citrineio/STM32F103_Temp_Sense/README.md

# STM32F103_Temp_Sense
STM32F103 based development board featuring a TI TMP102 temperature sensor and pin headers for various interfaces.
