citrineio/STM32F103_Temp_Sense/Schematics/Readme.md

# Schematics

Here you can download the schematics files for this project or view the PDF version.
