citrineio/STM32F103_Temp_Sense/Schematics/01-Schematics.kicad_sch

## KiCad design Schematics/01-Schematics.kicad_sch (2023-05-26)

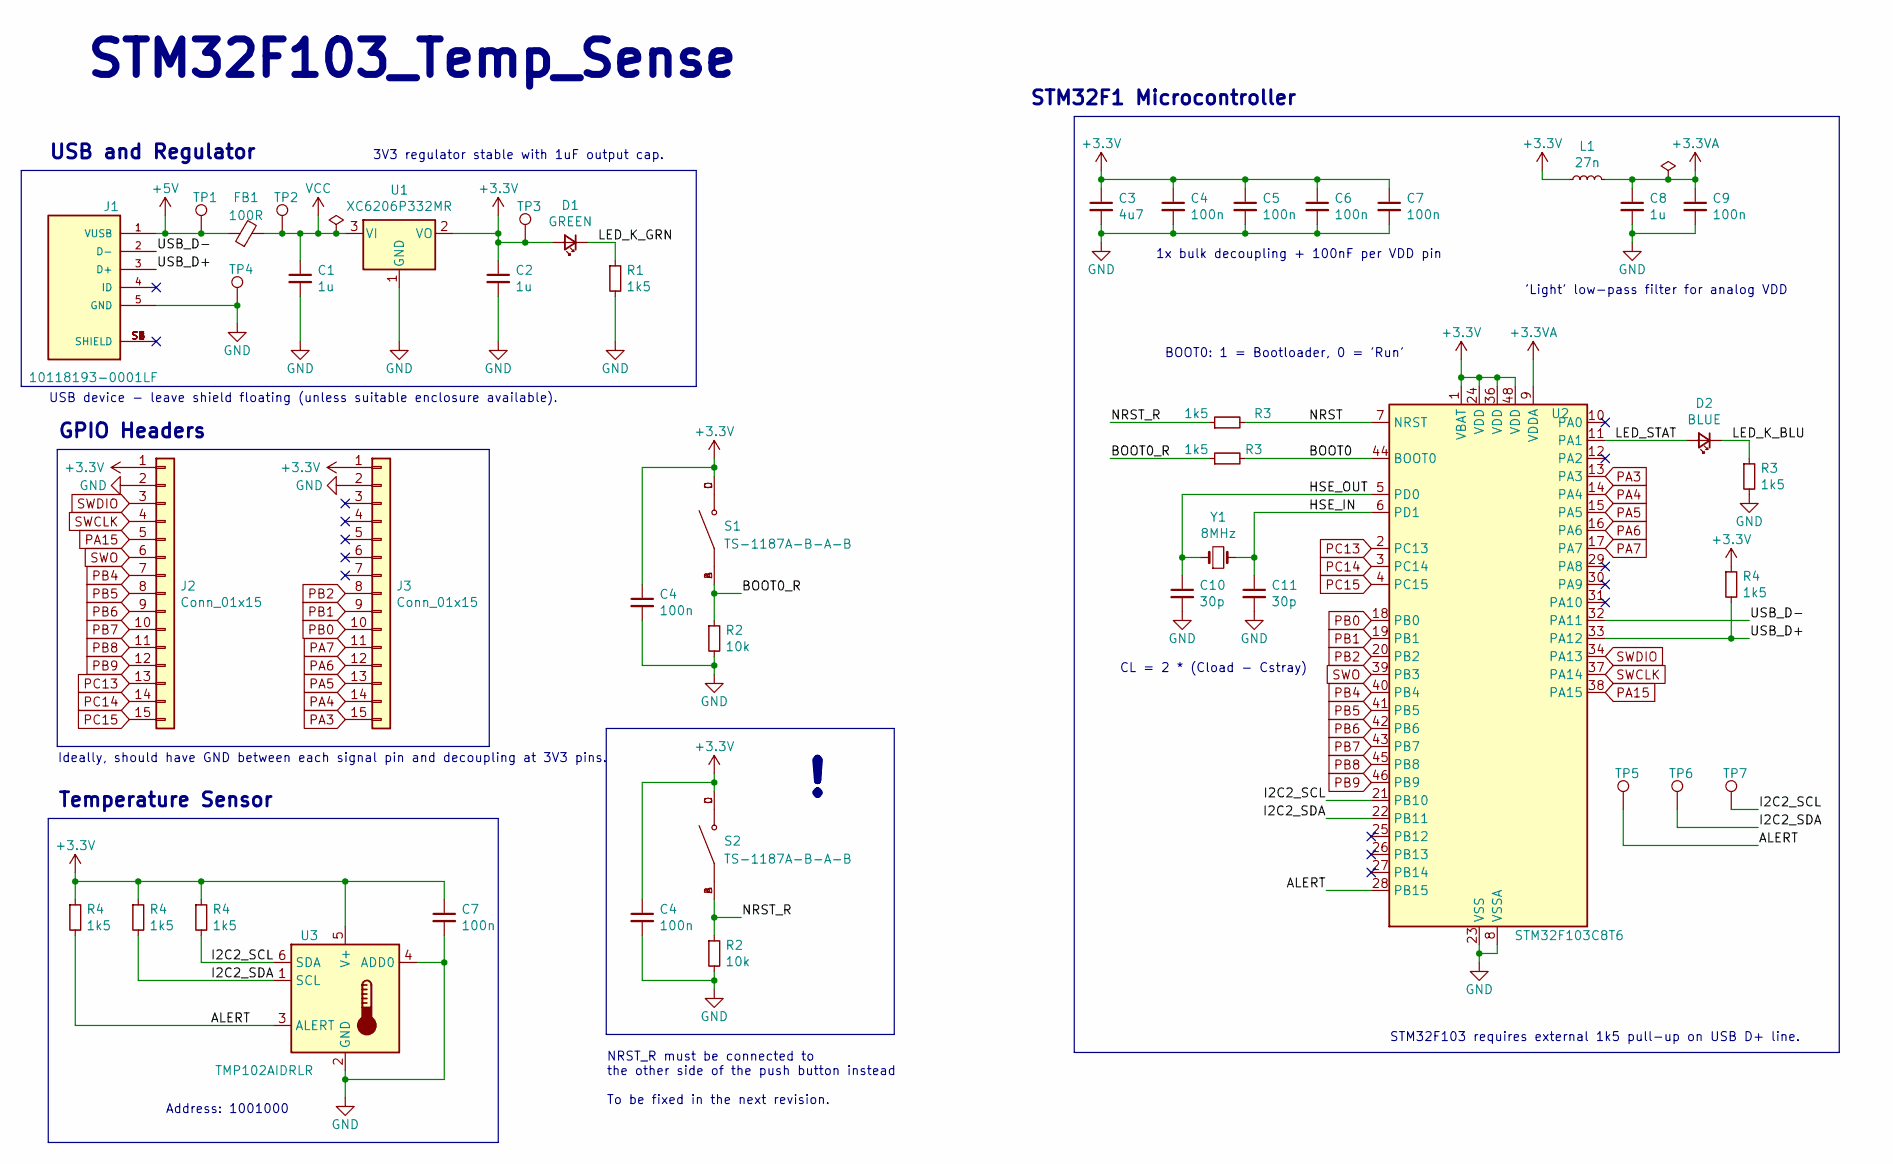
[picture p3: schematic 01-Schematics.kicad_sch]

Parts:
C1, C2: 1u; C_0603_1608Metric; LCSC Part # C15849
C3: 4u7; C_0603_1608Metric; LCSC Part # C19666
C4, C5, C6, C7, C9: 100n; C_0402_1005Metric; LCSC Part # C1525
C8: 1u; C_0402_1005Metric; LCSC Part # C52923
C10, C11: 30p; C_0402_1005Metric; LCSC Part # C1570
D1: GREEN; LED_0603_1608Metric; LCSC Part # C72043
D2: BLUE; LED_0603_1608Metric; LCSC Part # C72041
FB1: 100R; L_0805_2012Metric; LCSC Part # C1015
J1: 10118193-0001LF; AMPHENOL_10118193-0001LF; LCSC Part # C132562
J2, J3: Conn_01x15; PinHeader_1x15_P2.54mm_Vertical; LCSC Part # C2894938
L1: 27n; L_0402_1005Metric; LCSC Part # C18830
R1, R3: 1k5; R_0603_1608Metric; LCSC Part # C22843
R2: 10k; R_0402_1005Metric; LCSC Part # C25744
R4: 1k5; R_0402_1005Metric; LCSC Part # C25867
S1, S2: TS-1187A-B-A-B; SW_TS-1187A-B-A-B; LCSC Part # C318884
TP1, TP2, TP3, TP4, TP5, TP6, TP7: TestPoint; TestPoint_Pad_D1.0mm
U1: XC6206P332MR; SOT-23; LCSC Part # C5446
U2: STM32F103C8T6; LQFP-48_7x7mm_P0.5mm; LCSC Part # C8734
U3: TMP102AIDRLR; SOT50P160X60-6N; LCSC Part # C99269
Y1: 8MHz; Crystal_SMD_5032-2Pin_5.0x3.2mm; LCSC Part # C115962

Connections:
+3.3V: C2.1, C3.1, C4.1, C5.1, C6.1, C7.1, D1.2 (A), J2.1, J3.1, L1.1, R4.1, S1.C, S1.D, S2.C, S2.D, TP3.1, U1.2 (VO), U2.1 (VBAT), U2.24 (VDD), U2.36 (VDD), U2.48 (VDD), U3.5 (V+)
+3.3VA: C8.1, C9.1, L1.2, U2.9 (VDDA)
+5V: FB1.1, J1.1 (VUSB), TP1.1
ALERT: R4.2, TP5.1, U2.28 (PB15), U3.3 (ALERT)
BOOT0: R3.2, U2.44 (BOOT0)
BOOT0_R: R2.1, R3.1, S1.A, S1.B
GND: C1.2, C2.2, C3.2, C4.2, C5.2, C6.2, C7.2, C8.2, C9.2, C10.2, C11.2, J1.5 (GND), J2.2, J3.2, R1.2, R2.2, R3.2, TP4.1, U1.1 (GND), U2.8 (VSSA), U2.23 (VSS), U2.35 (VSS), U2.47 (VSS), U3.2 (GND), U3.4 (ADD0)
HSE_IN: C11.1, U2.6 (PD1), Y1.2
HSE_OUT: C10.1, U2.5 (PD0), Y1.1
I2C2_SCL: R4.2, TP7.1, U2.21 (PB10), U3.6 (SDA)
I2C2_SDA: R4.2, TP6.1, U2.22 (PB11), U3.1 (SCL)
LED_K_BLU: D2.1 (K), R3.1
LED_K_GRN: D1.1 (K), R1.1
LED_STAT: D2.2 (A), U2.11 (PA1)
NRST: R3.2, U2.7 (NRST)
NRST_R: R2.1, R3.1, S2.A, S2.B
unnamed: J1.S1 (SHIELD), J1.S2 (SHIELD), J1.S3 (SHIELD), J1.S4 (SHIELD), J1.S5 (SHIELD), J1.S6 (SHIELD)
PA3: J3.15, U2.13 (PA3)
PA4: J3.14, U2.14 (PA4)
PA5: J3.13, U2.15 (PA5)
PA6: J3.12, U2.16 (PA6)
PA7: J3.11, U2.17 (PA7)
PA15: J2.5, U2.38 (PA15)
PB0: J3.10, U2.18 (PB0)
PB1: J3.9, U2.19 (PB1)
PB2: J3.8, U2.20 (PB2)
PB4: J2.7, U2.40 (PB4)
PB5: J2.8, U2.41 (PB5)
PB6: J2.9, U2.42 (PB6)
PB7: J2.10, U2.43 (PB7)
PB8: J2.11, U2.45 (PB8)
PB9: J2.12, U2.46 (PB9)
PC13: J2.13, U2.2 (PC13)
PC14: J2.14, U2.3 (PC14)
PC15: J2.15, U2.4 (PC15)
SWCLK: J2.4, U2.37 (PA14)
SWDIO: J2.3, U2.34 (PA13)
SWO: J2.6, U2.39 (PB3)
USB_D+: J1.3 (D+), R4.2, U2.33 (PA12)
USB_D-: J1.2 (D-), U2.32 (PA11)
VCC: C1.1, FB1.2, TP2.1, U1.3 (VI)

Notes on the sheet:
3V3 regulator stable with 1uF output cap.
'Light' low-pass filter for analog VDD
USB device - leave shield floating (unless suitable enclosure available).
STM32F1 Microcontroller
STM32F103 requires external 1k5 pull-up on USB D+ line.
GPIO Headers
1x bulk decoupling + 100nF per VDD pin
USB and Regulator
CL = 2 * (Cload - Cstray)
Temperature Sensor
Address: 1001000
STM32F103_Temp_Sense
BOOT0: 1 = Bootloader, 0 = 'Run'
NRST_R must be connected to the other side of the push button instead To be fixed in the next revision.
Ideally, should have GND between each signal pin and decoupling at 3V3 pins.
