citrineio/STM32F103_Temp_Sense/Schematics/STM32F103_Temp_Sense.kicad_sch

## KiCad design Schematics/STM32F103_Temp_Sense.kicad_sch (2023-05-26)

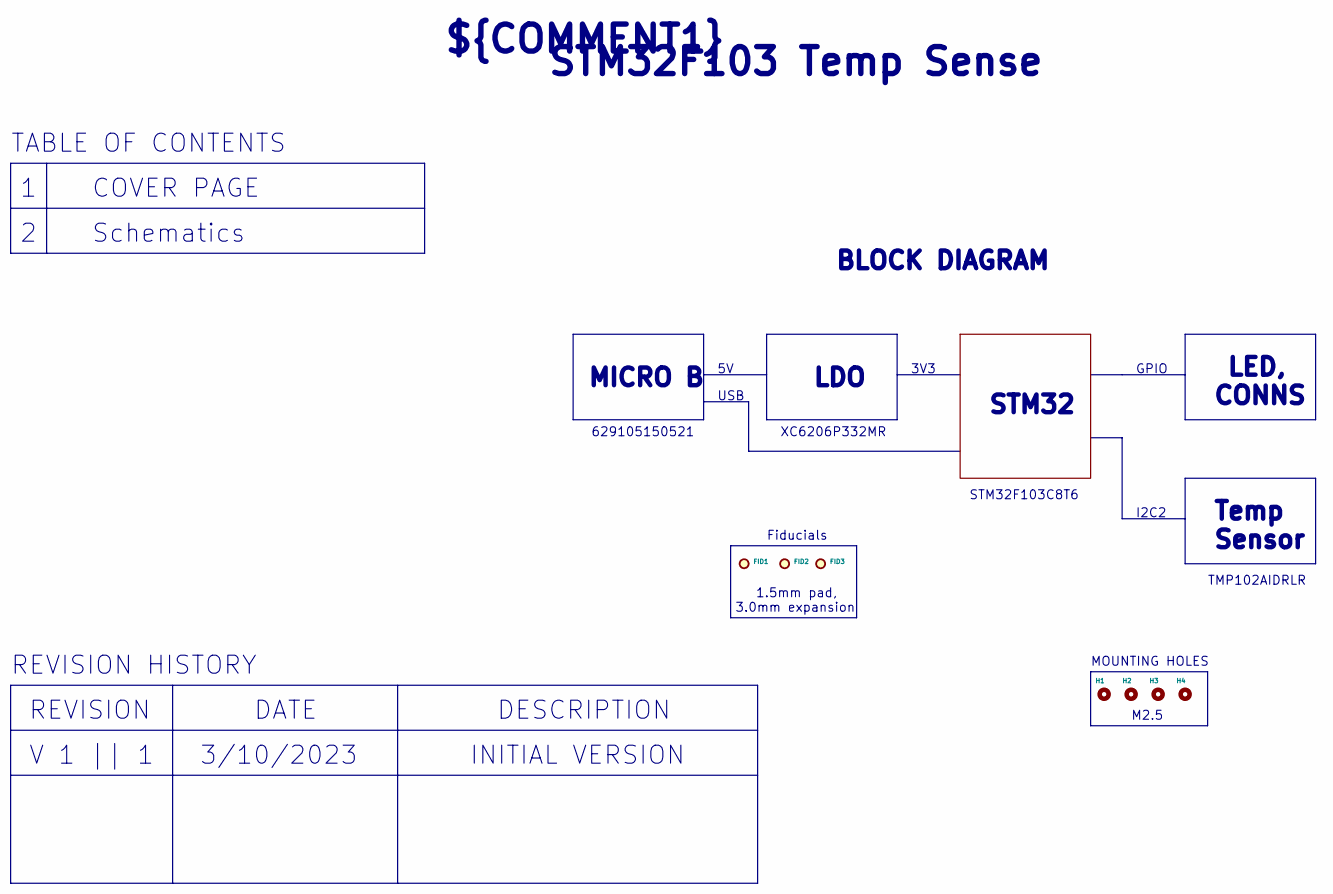
[picture p4: schematic STM32F103_Temp_Sense.kicad_sch]

Parts:
FID1, FID2, FID3: Fiducial; Fiducial_1.5mm_Mask3mm
H1, H2, H3, H4: MountingHole_Pad; MountingHole_2.7mm_M2.5

Notes on the sheet:
3/10/2023
STM32
INITIAL VERSION
GPIO
I2C2
BLOCK DIAGRAM
MOUNTING HOLES
V 1 || 1
USB
REVISION HISTORY
629105150521
M2.5
1.5mm pad, 3.0mm expansion
Schematics
DATE
LDO
${TITLE}
COVER PAGE
${COMMENT1}
STM32F103C8T6
3V3
LED, CONNS
TMP102AIDRLR
DESCRIPTION
Fiducials
REVISION
MICRO B
Temp Sensor
TABLE OF CONTENTS
XC6206P332MR
